egalistel-dev/MailSense32/(notices)

Notices in the files:
MailSense32.ino:
egamaker.be" target="_blank">Egalistel / egamaker.be — MIT License
